botblox/RouterCoreCore-Baseboard-Designs/RouterCoreBaseRevA Manufacture Files/Impedance requirement/BOT-DiffPair100Ohm_YellowHighlighted.pdf

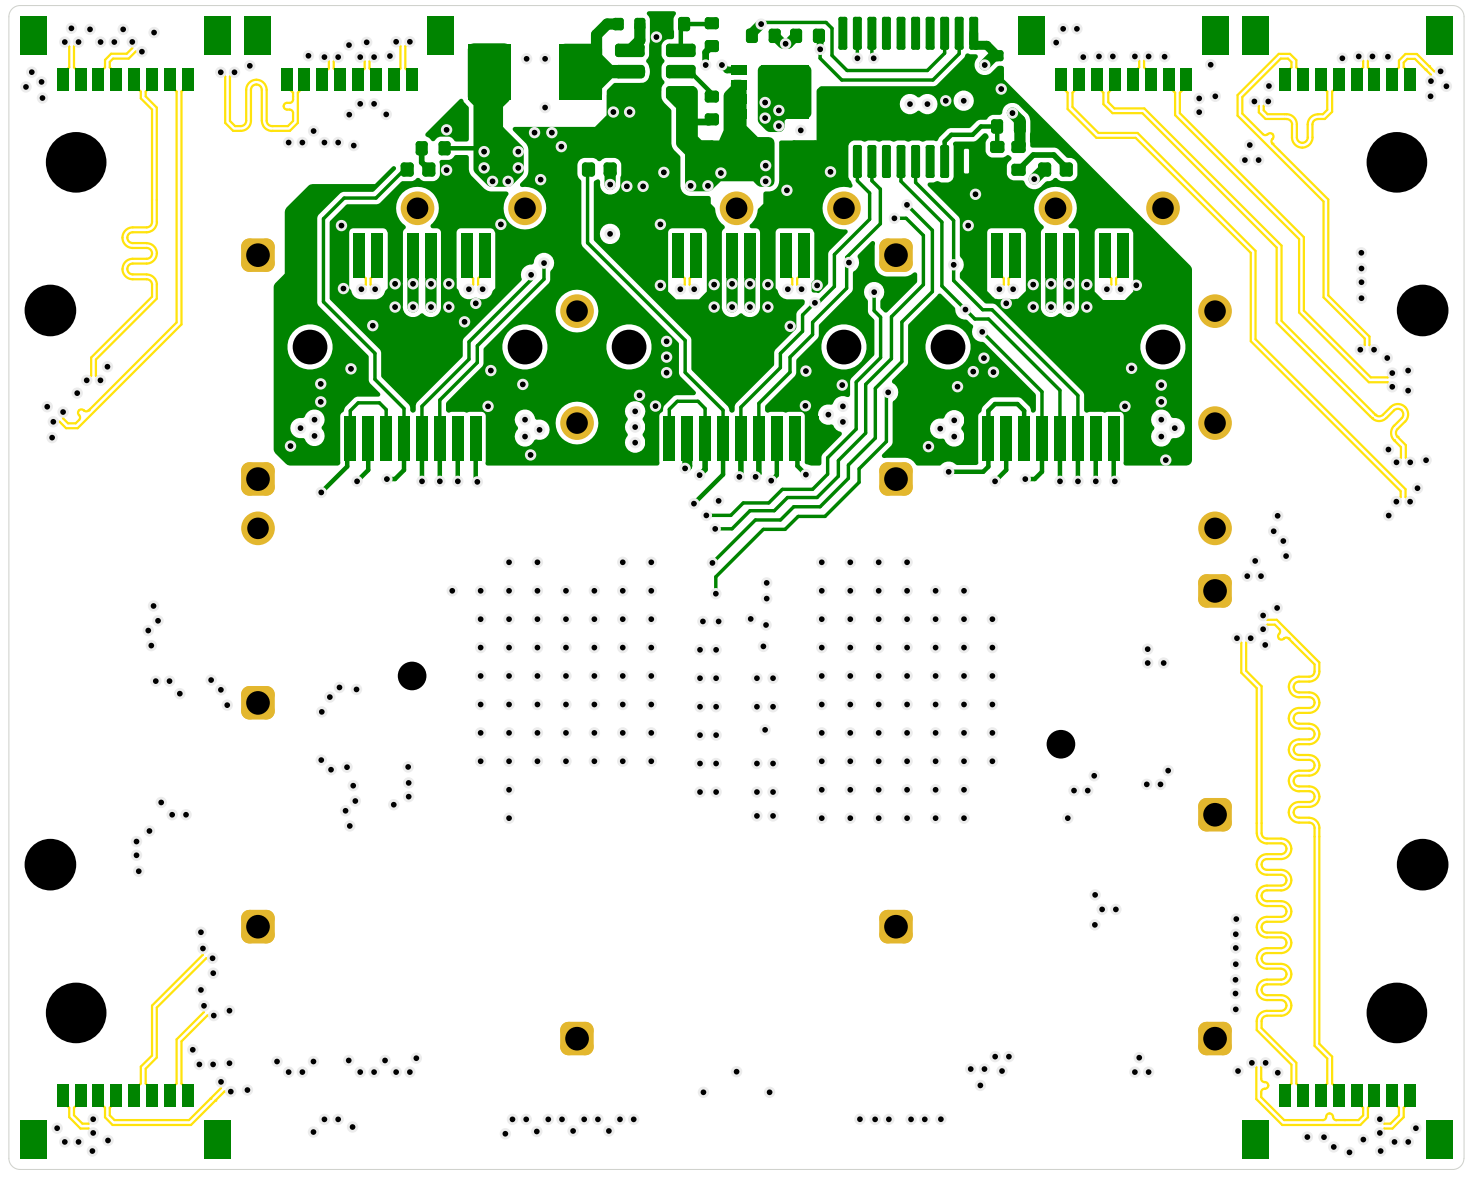
[picture p4: page 1]
