botblox/RouterCoreCore-Baseboard-Designs/RouterCoreBaseRevA Manufacture Files/Impedance requirement/IN2-DiffPair100Ohm_YellowHighlighted.pdf

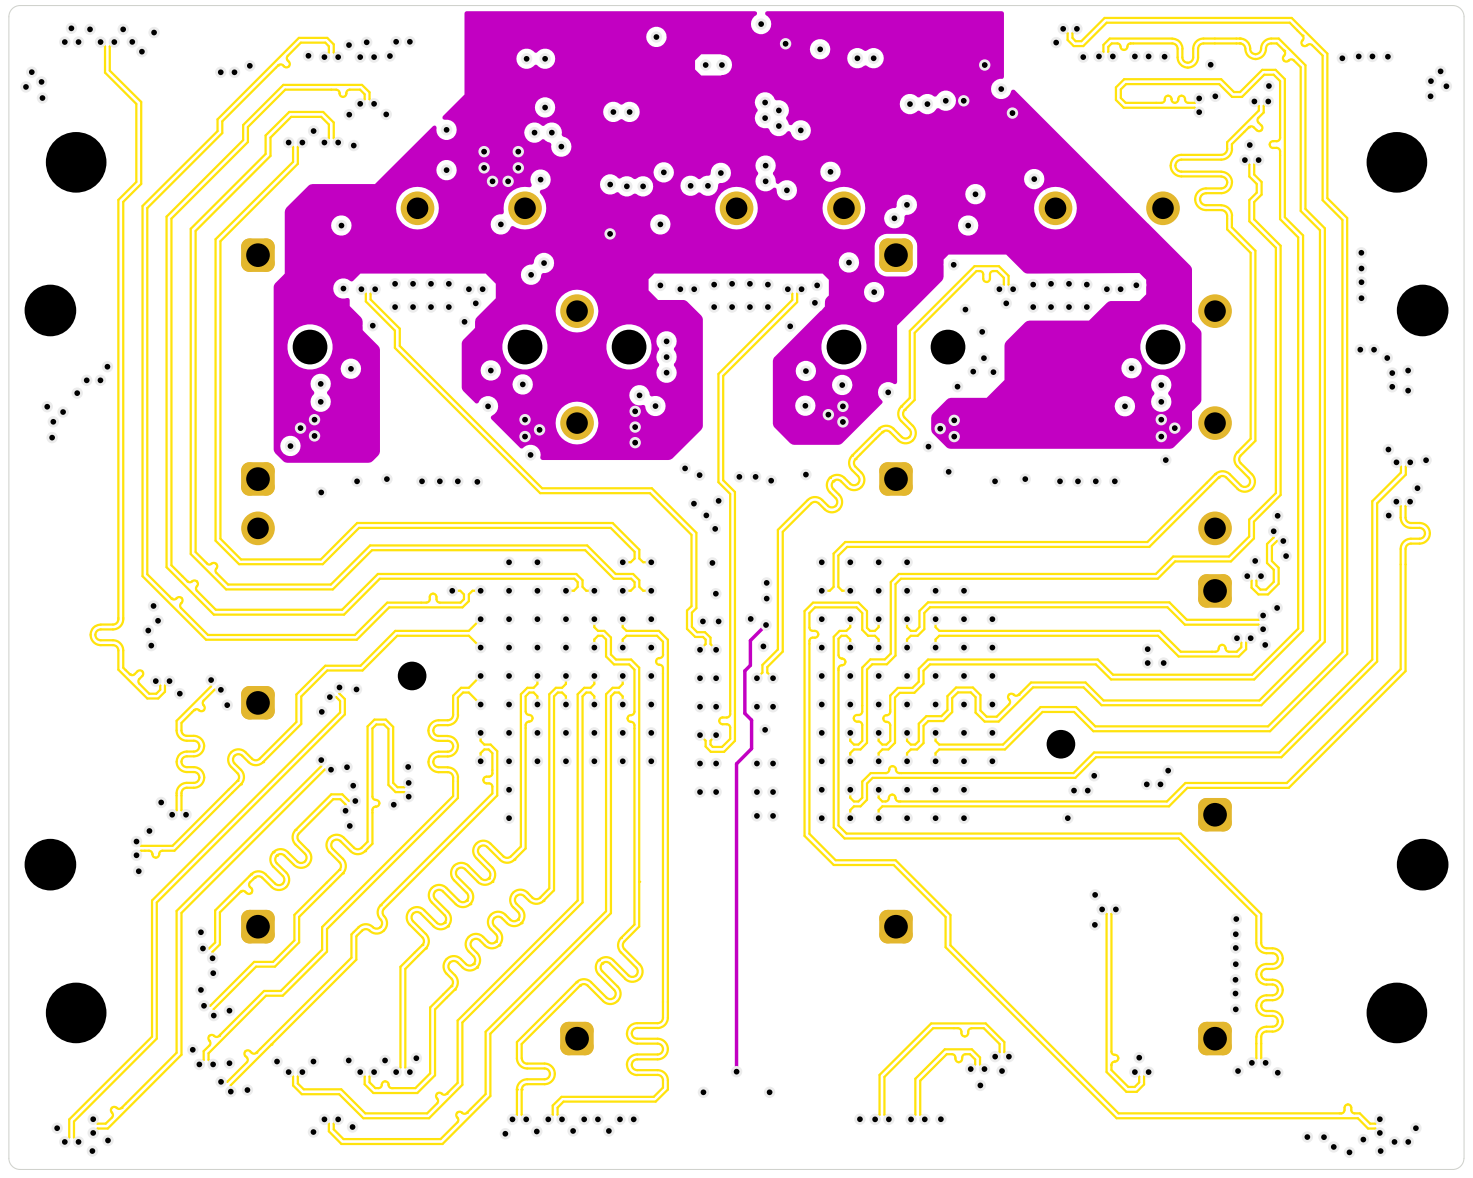
[picture p5: page 1]
