botblox/RouterCoreCore-Baseboard-Designs/RouterCoreBaseRevA Manufacture Files/Impedance requirement/IN4-DiffPair100Ohm_YellowHighlighted.pdf

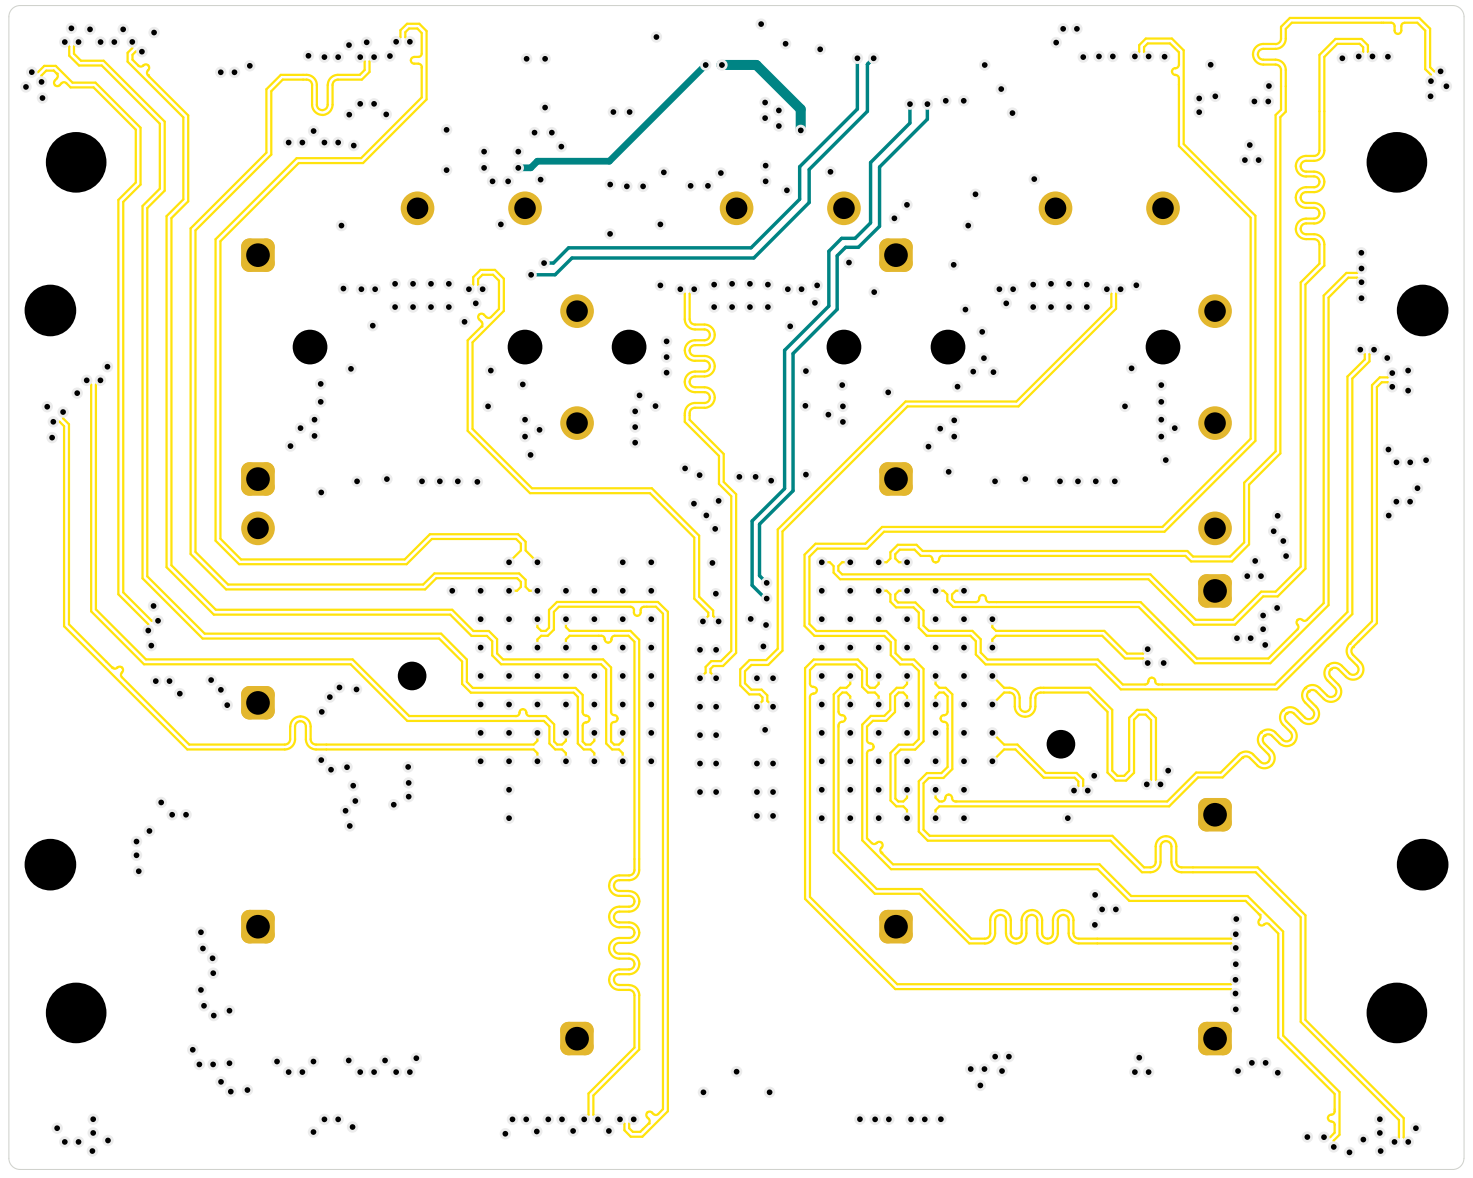
[picture p6: page 1]
