botblox/RouterCoreCore-Baseboard-Designs/RouterCoreBaseRevA Manufacture Files/Impedance requirement/TOP-DiffPair100Ohm_YellowHighlighted.pdf

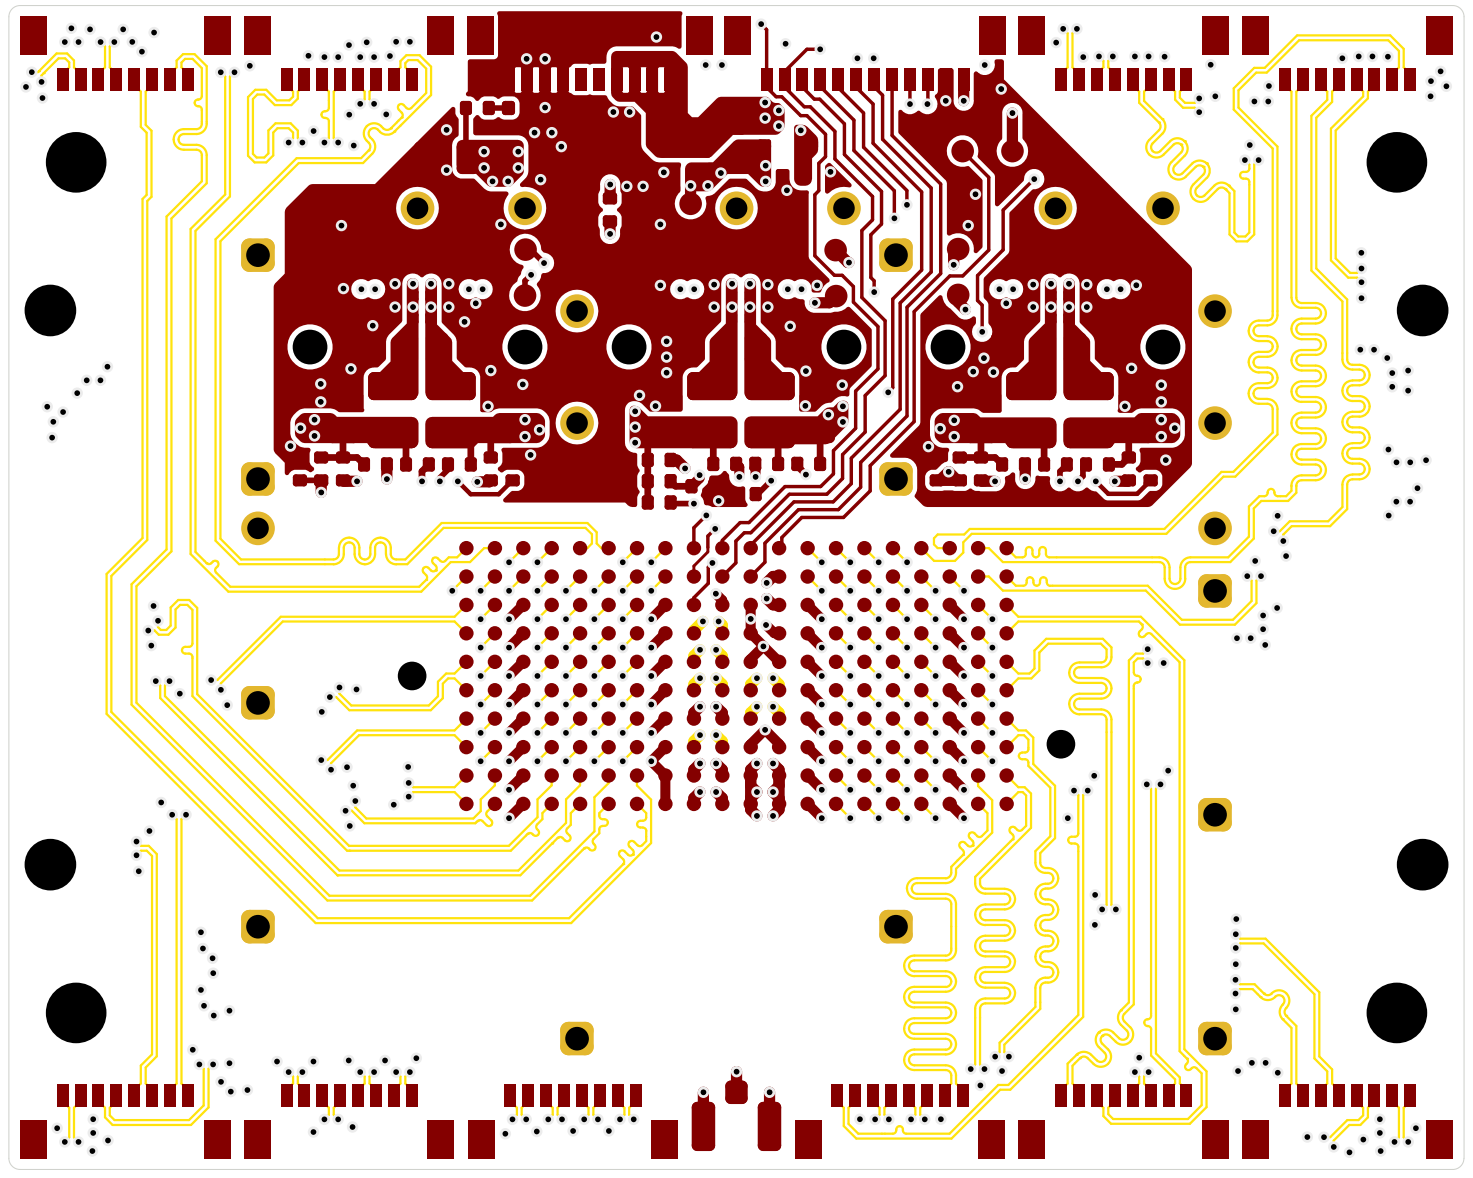
[picture p7: page 1]
