botblox/RouterCoreCore-Baseboard-Designs/RouterCoreBaseRevA Manufacture Files/3D Images/BB-RPB-A-1 BOT.png

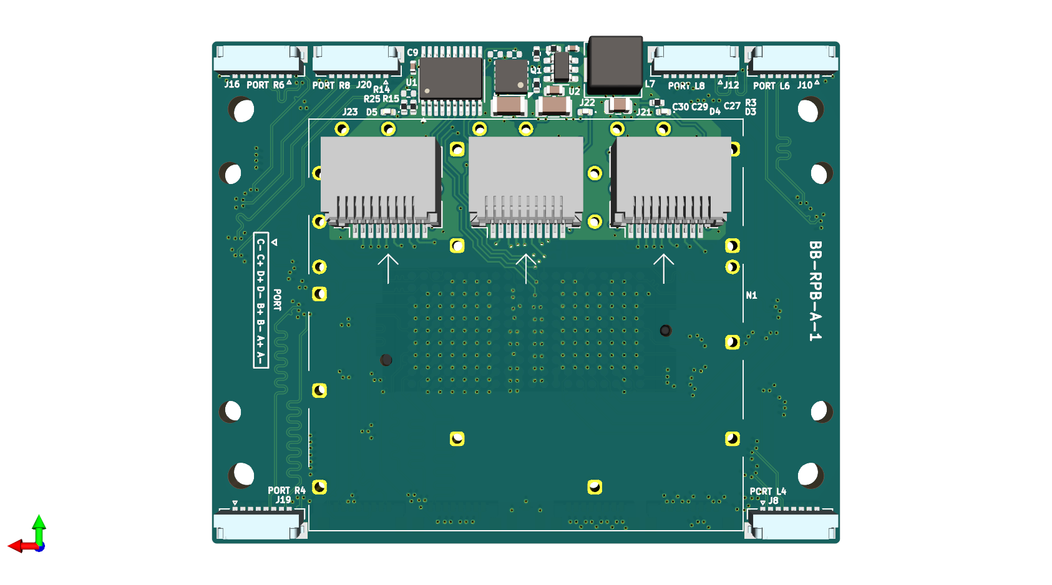
RouterCoreBaseRevA Manufacture Files/3D Images/BB-RPB-A-1 BOT.png
