botblox/RouterCoreCore-Baseboard-Designs/RouterCoreBaseRevA Manufacture Files/3D Images/BB-RPB-A-1 TOP2.png

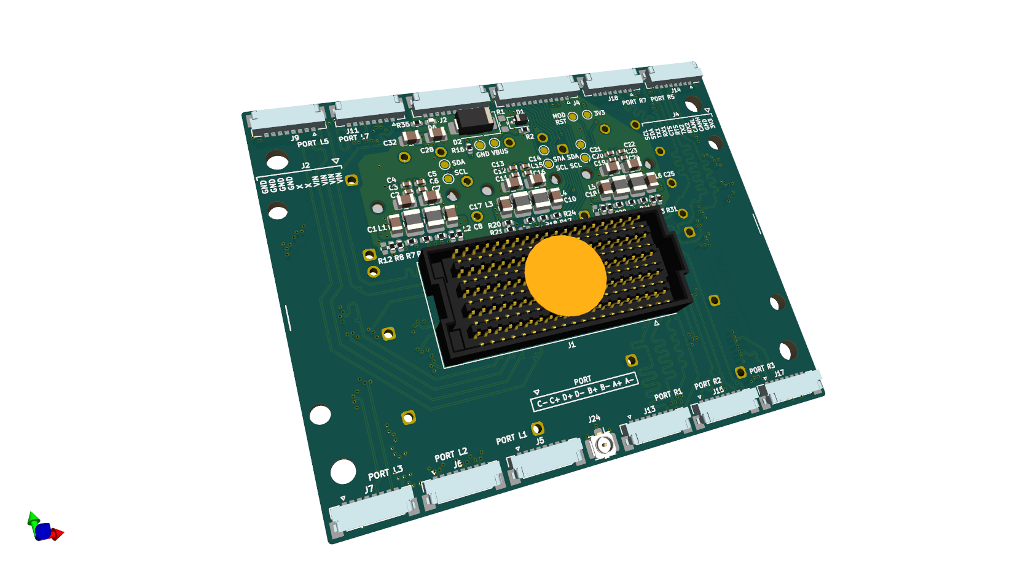
RouterCoreBaseRevA Manufacture Files/3D Images/BB-RPB-A-1 TOP2.png
